openscienceschool/di-lambda/3D_files/Cuvette_holder/README.md

## 3D printing

The part can be printed on a good quality FDM 3D printer, 0.2mm layer height. Black PLA should be used.
Trim away any imperfections and stringing before installing.



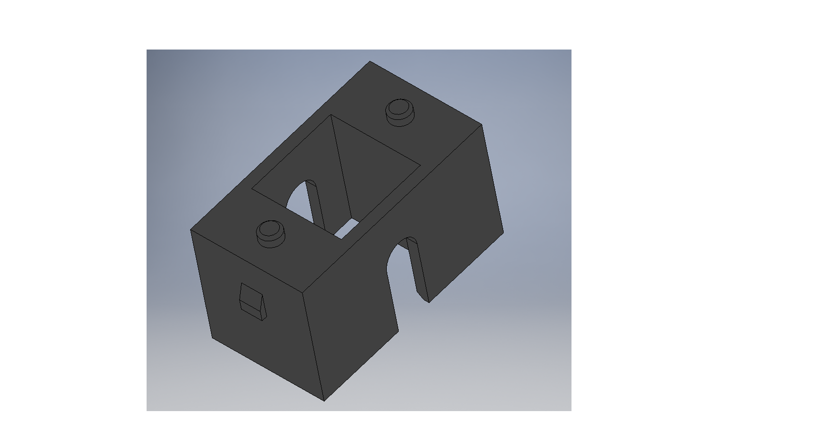
[picture p2: 3D_files/Cuvette_holder/Cuvette_holder1.png]

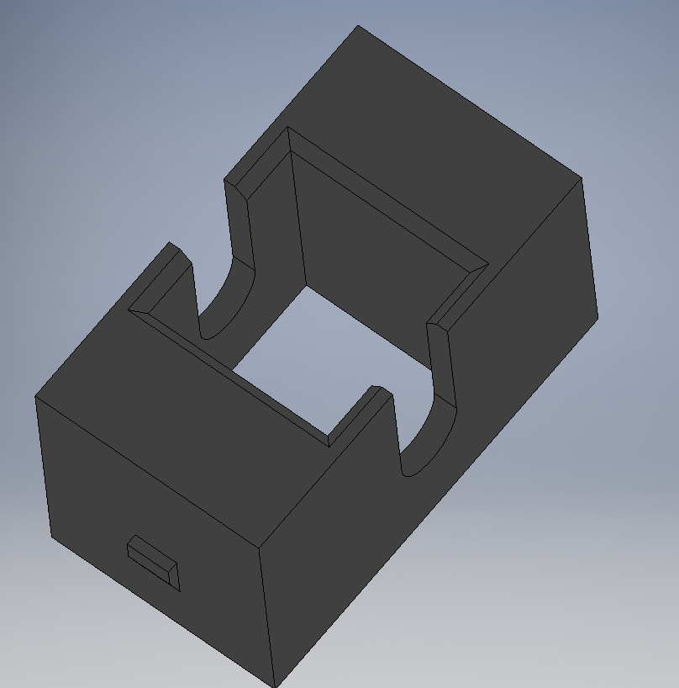
[picture p3: 3D_files/Cuvette_holder/Cuvette_holder2.png]
