openscienceschool/di-lambda/3D_files/Button_pusher/README.md

## 3D printing

Print with SLA or SLS, tolerance 0.15mm.
Inspect the printed parts and remove any imporfections with a knife.

Check fit and button functionality after installation. Adjust if needed.

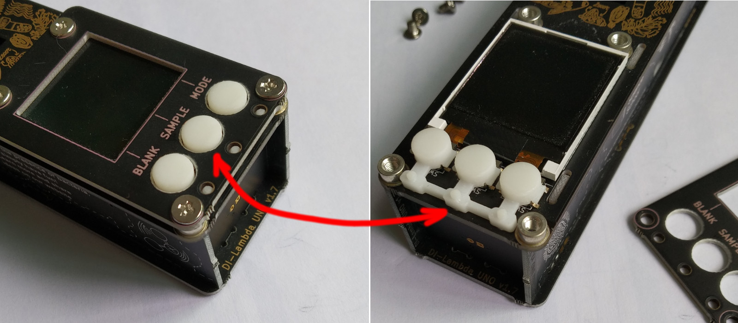
[picture p4: 3D_files/Button_pusher/Button_pusher_installed.jpg]


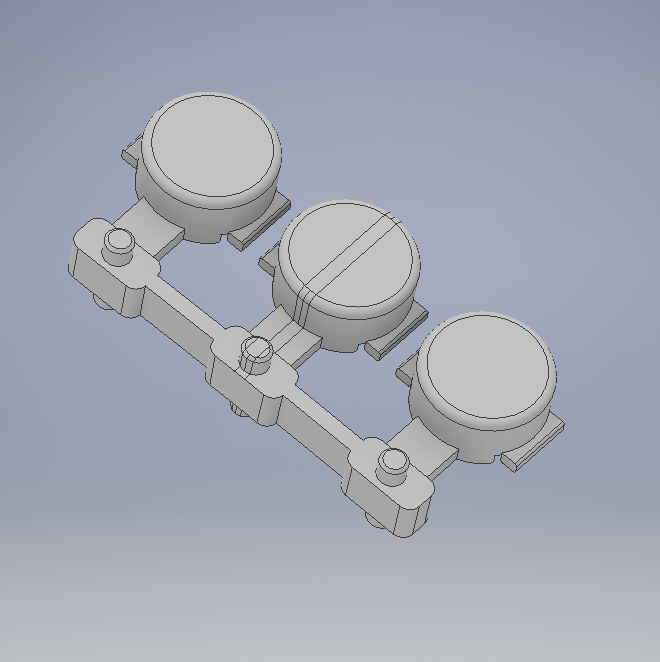
[picture p5: 3D_files/Button_pusher/Button_pusher1.png]

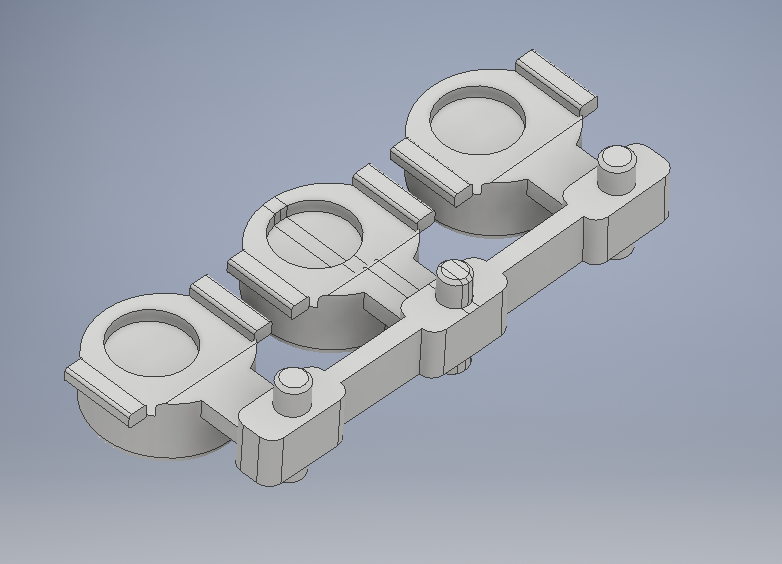
[picture p6: 3D_files/Button_pusher/Button_pusher2.png]
