openscienceschool/di-lambda/3D_files/Button_pusher/Button_pusher.stp

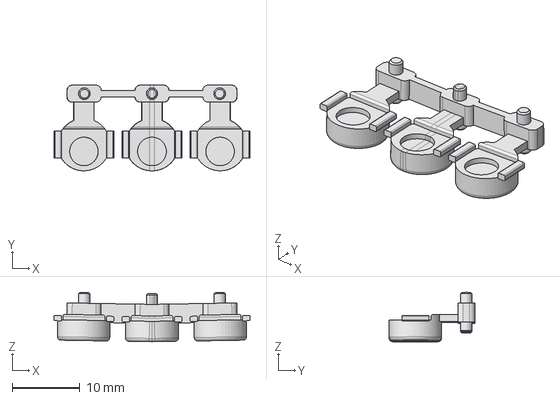
[picture p7: CAD file, 2018-10-23]
3D_files/Button_pusher/Button_pusher.stp
28.8 x 12.6 x 7.28 mm
