openscienceschool/di-lambda/3D_files/Cuvette_holder/Cuvette_holder.stp

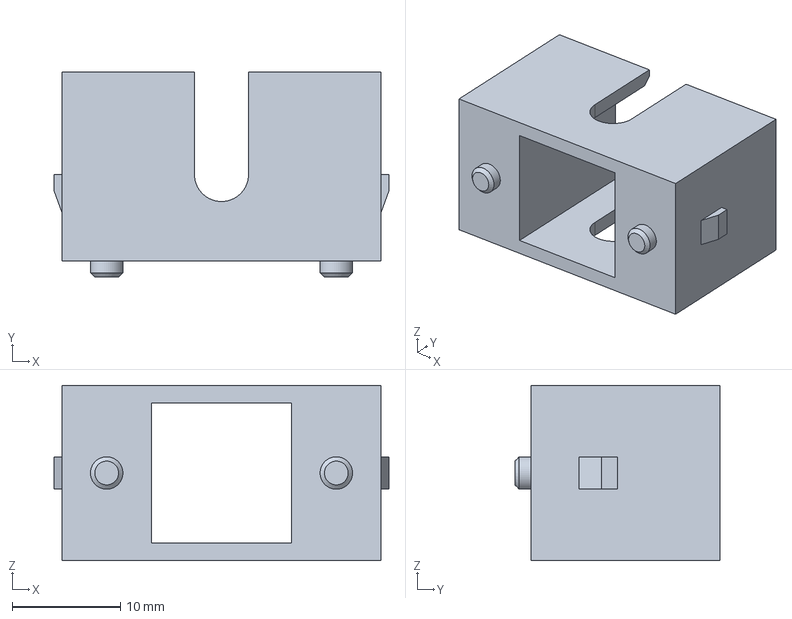
[picture p8: CAD file, 2018-10-23]
3D_files/Cuvette_holder/Cuvette_holder.stp
31.0 x 19.0 x 16.2 mm
