openscienceschool/di-lambda/(list of files, cad)

Other CAD files:
3D_files/Button_pusher/Button_pusher.stl
3D_files/Cuvette_holder/Cuvette_holder.stl
