openscienceschool/di-lambda/(commit log)

2018-10-23 Initial import of current production files for version 1.7
    [Button_pusher.stl, Button_pusher.stp, Cuvette_holder.stl, Cuvette_holder.stp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]
2018-10-23 Clean up and expand the button pusher readme file.
2018-10-23 3D files: Add photos of the installed button pusher
2018-10-23 Fix the installed button pusher file name.
2018-11-01 Clarify the BOM
    [DI-Lambda-UNO-v1.7-BOM.xlsx]
